dabstractor/roxanne-shoes/shoe_export.3mf

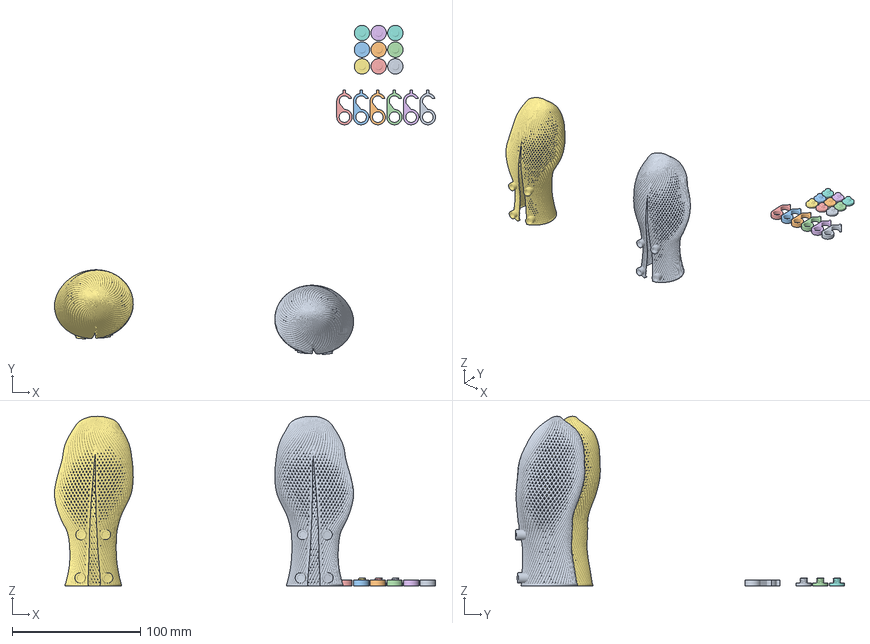
[picture p1: CAD file, 2026-07-14]
shoe_export.3mf
297.0 x 256.8 x 132.2 mm
Left Shoe
Post head.stl x 9
Latch.stl x 6
Right Shoe
