dabstractor/roxanne-shoes/Latch.stl

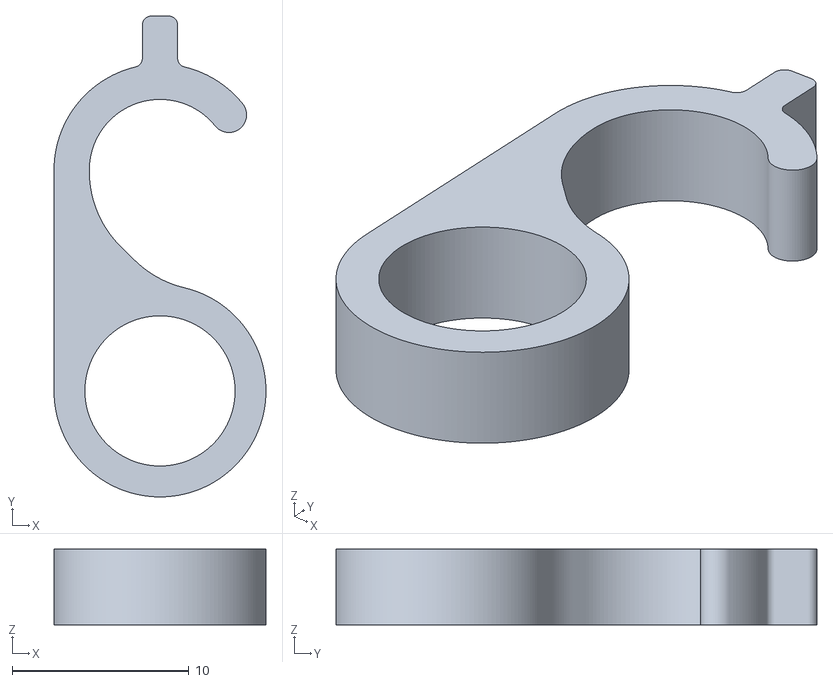
[picture p2: CAD file, 2026-07-11]
Latch.stl
12.0 x 27.2 x 4.30
