dabstractor/roxanne-shoes/Post.stl

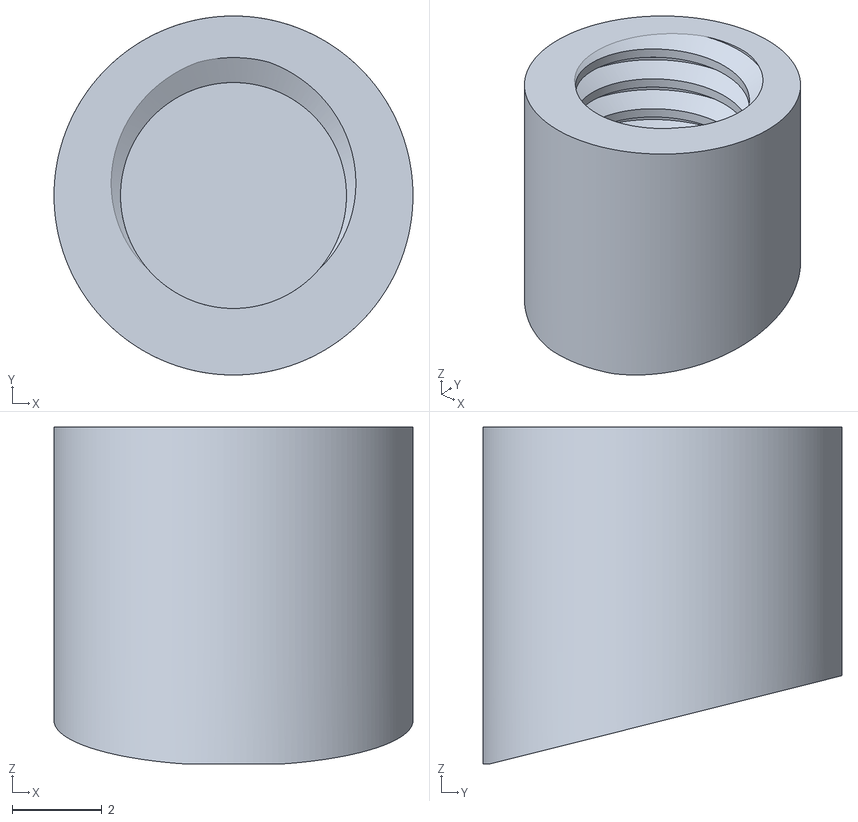
[picture p3: CAD file, 2026-07-07]
Post.stl
8.00 x 8.00 x 7.50
