dabstractor/roxanne-shoes/Post head.stl

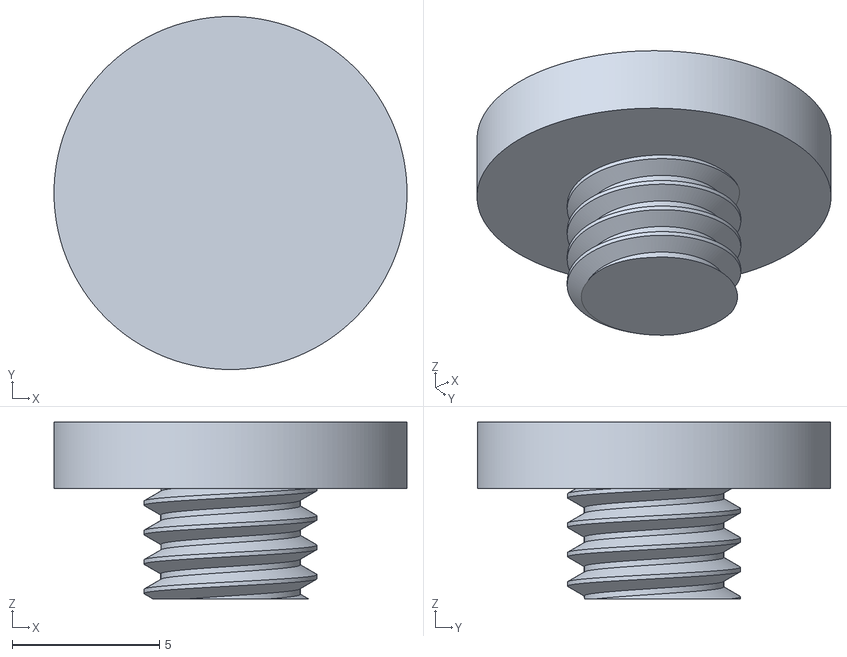
[picture p4: CAD file, 2026-06-22]
Post head.stl
12.0 x 12.0 x 6.00
