dabstractor/roxanne-shoes/post-test.stl

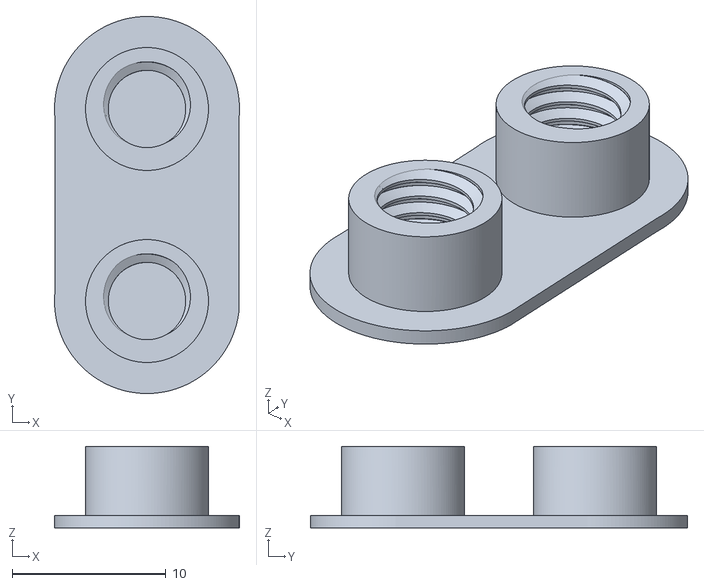
[picture p5: CAD file, 2026-06-19]
post-test.stl
12.0 x 24.5 x 5.31
