dabstractor/roxanne-shoes/left boot cutout meters.stl

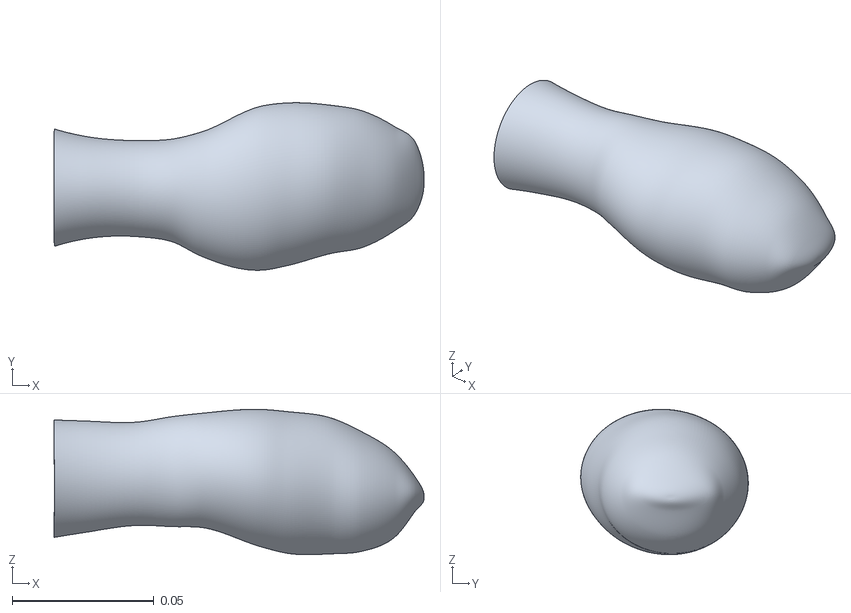
[picture p6: CAD file, 2026-06-17]
left boot cutout meters.stl
0.13 x 0.0591 x 0.0512
