dabstractor/roxanne-shoes/(list of files, cad)

Other CAD files:
shoe.blend
