dabstractor/roxanne-shoes/(commit log)

2026-06-17 feat: add tongue generation and vented shell cutting scriptsInclude diagnostic tools for printability and tongue alignmentExport pipeline converts curves to mesh and joins geometryFocus on crosshatch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
2026-06-17 feat: add non-destructive STL export for curves
2026-06-18 feat: add simple latch and post mesh
    [Latch.stl, Post head.stl, Post.stl, post-test.stl]
2026-06-18 feat: resize test post
    [Post head.stl, post-test.stl]
2026-06-18 feat: resize test posts
    [Latch.stl, Post head.stl, Post.stl, post-test.stl]
2026-06-19 feat: extend ankle cuff and tongue to new print plane
2026-06-19 feat: resize post threads
    [Post head.stl, Post.stl, post-test.stl]
2026-06-20 extend post length
    [Post.stl]
2026-06-20 fix: reverse V-band winding for one arm to correct normals
2026-06-20 fix: anchor V-band tip to rail surface and correct normals
2026-06-20 fix: cut angle in post
    [Post.stl]
2026-06-22 fix: widen post cap threads
    [Post head.stl]
2026-07-07 removed female thread offset from post, better fit
    [Post.stl]
2026-07-07 remove tongue and solid bands, add ankle rim
    [shoe.blend]
2026-07-07 shift right-side posts inward to match left clearance
    [shoe.blend]
2026-07-07 add latch support
    [Latch.stl]
2026-07-11 update latch design
    [Latch.stl]
2026-07-11 reduce cuff thickness and widen thin floor for balance
    [shoe.blend, shoe_export.3mf]
2026-07-14 remove shoe export file
    [shoe_export.3mf]
